salmajidah/Air-Humidifier/README.md

# Air-Humidifier
Air Humidifier arduino based-code
using mist maker (D2), fan (D3), and DHT 11 temperature and humidity sensor (A0).
Threshold of the humidity is set by potentiometer.
